42CrMo4/Timer/requirementsSW.rtf

Startup:
- wake from deep sleep on any key stroke with interrupt (Flag int)

Going to sleep:
- Always if idl (no timer, stopwatch running) go to sleep after „idl_timeout“ in sec after the last input
- The „idl_timeout“ should be configurable at the beginning of the sketch

Timer funktion:
- input time in format hh:mm:ss but start with the right most digit (s) and shift then to the left.
- example: input 13min and 25sec
- 00:00:00 (start frame)
- 00:00:01 (enter 1)
- 00:00:13 (enter 3)
- 00:01:32 (enter 2)
- 00:13:25 (enter 5)
- start timer with press on Start Key (Flag ButtonStart)
- OLED should show the time remaining
- (optional) OLED should show a hourglass symbol before time
- If running Pause Timer with press on Start Key (Flag ButtonStart)
- (optional) OLED should not show a hourglass symbol before time
- Reset Timer by pressing Reset Key (Flag ButtonReset)
- if running or in paused mode rest to the last input time (example from bevor 13:25)
- if reseted again then go to 00:00:00
- in input mode reset to 00:00:00
- If Time reaches 00:00:00
- the buzzer (Flag Buzzer) should sound.
- The frequency should be configurable at the beginning of the sketch
- The duration should be configurable at the beginning of the sketch
- (optional) the display should invert the colors 5 times (to have a blinking effect)
- the time should go on and count up (so that you know the elapsed time since the end of the timer
- (optional) The hourglass should be changed to a big „E“

Stopwatch funktion:
- start stopwatch with press on Start Key (Flag ButtonStart)
- OLED should show the time elapsed
- (optional) OLED should show a stopwatch symbol before time
- If running Pause stopwatch with press on Start Key (Flag ButtonStart)
- Reset stopwatch if running or in paused mode by pressing Reset Key (Flag ButtonReset)

Generell Concept:
- Arduino IDE
- Microcontroller Attiny1616
- use megaTinyCore (https://github.com/SpenceKonde/megaTinyCore)
- No floating pins in sleep mode (https://github.com/SpenceKonde/megaTinyCore/blob/master/megaavr/extras/PowerSave.md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)
- only open source Libraries
- if possible good maintained Libraries
- functions without delay
- icons used or inspired from the material design collection (https://materialdesignicons.com/)
