42CrMo4/Timer/Timer.kicad_pcb

## KiCad design Timer.kicad_pcb (2021-09-29)

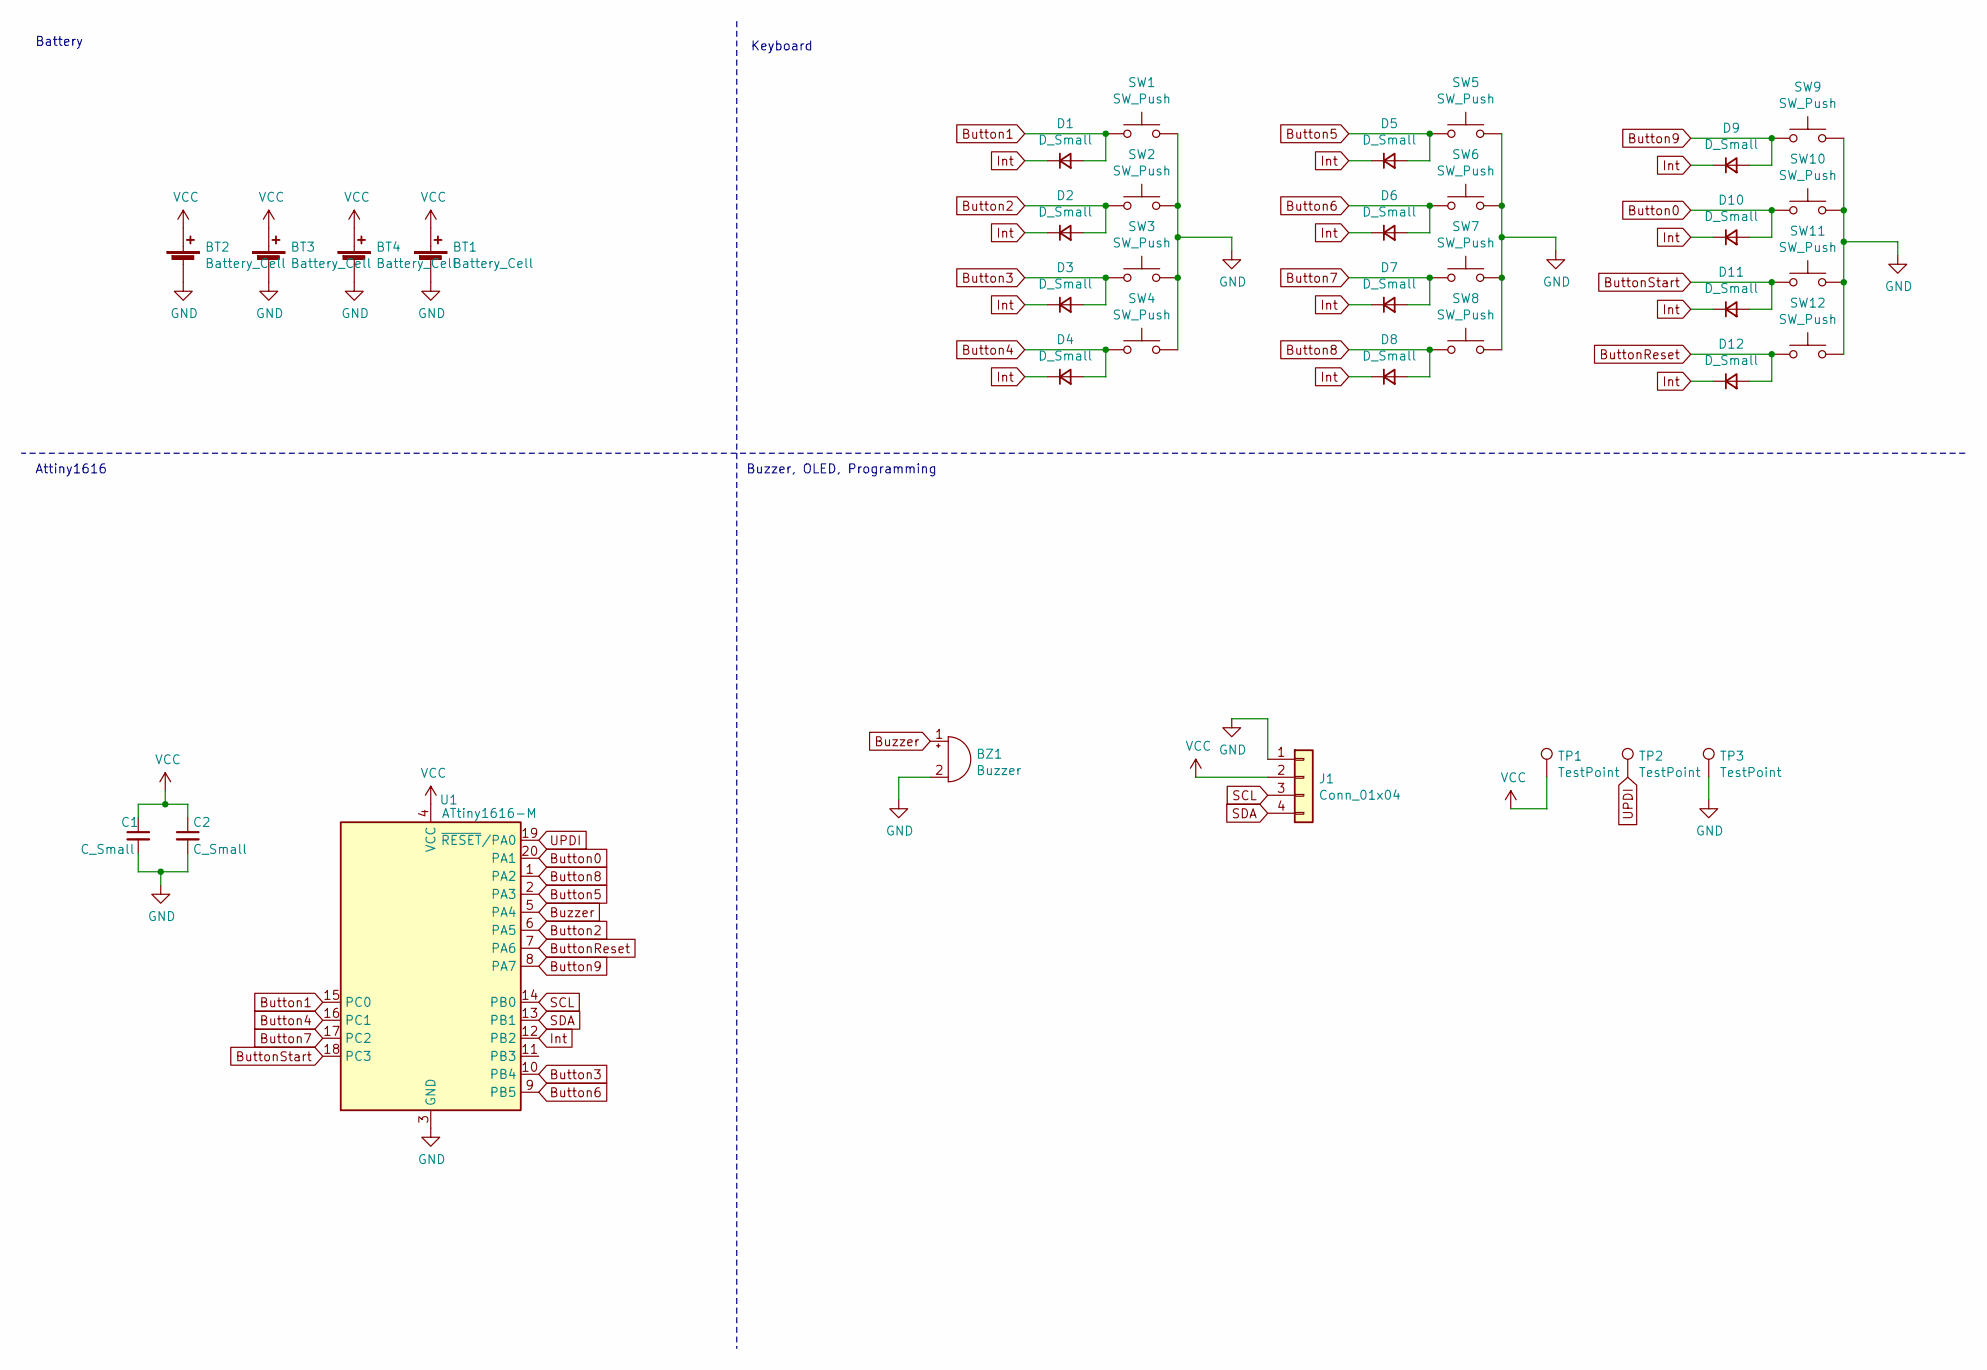
[picture p1: schematic Timer.sch]

Parts:
BT1, BT2, BT3, BT4: Battery_Cell; BatteryHolder_3DPrint_1xAAA
BZ1: Buzzer; Buzzer_12x9.5RM7.6
C1, C2: C_Small; C_0805_2012Metric
D1, D2, D3, D4, D5, D6, D7, D8, D9, D10, D11, D12: D_Small; D_0805_2012Metric
J1: Conn_01x04; PinHeader_1x04_P2.54mm_Vertical
SW1, SW2, SW3, SW4, SW5, SW6, SW7, SW8, SW9, SW10, SW11, SW12: SW_Push; SW_Cherry_MX_1.00u_PCB
TP1, TP2, TP3: TestPoint; TestPoint_Pad_D1.5mm
U1: ATtiny1616-M; VQFN-20-1EP_3x3mm_P0.4mm_EP1.7x1.7mm

Connections:
Button0: D10.2 (A), SW10.1, U1.20 (PA1)
Button1: D1.2 (A), SW1.1, U1.15 (PC0)
Button2: D2.2 (A), SW2.1, U1.6 (PA5)
Button3: D3.2 (A), SW3.1, U1.10 (PB4)
Button4: D4.2 (A), SW4.1, U1.16 (PC1)
Button5: D5.2 (A), SW5.1, U1.2 (PA3)
Button6: D6.2 (A), SW6.1, U1.9 (PB5)
Button7: D7.2 (A), SW7.1, U1.17 (PC2)
Button8: D8.2 (A), SW8.1, U1.1 (PA2)
Button9: D9.2 (A), SW9.1, U1.8 (PA7)
ButtonReset: D12.2 (A), SW12.1, U1.7 (PA6)
ButtonStart: D11.2 (A), SW11.1, U1.18 (PC3)
Buzzer: BZ1.1 (-), U1.5 (PA4)
GND: BT1.2 (-), BT2.2 (-), BT3.2 (-), BT4.2 (-), BZ1.2 (+), C1.2, C2.2, J1.1, SW1.2, SW2.2, SW3.2, SW4.2, SW5.2, SW6.2, SW7.2, SW8.2, SW9.2, SW10.2, SW11.2, SW12.2, TP3.1, U1.3 (GND), U1.21 (GND)
Int: D1.1 (K), D2.1 (K), D3.1 (K), D4.1 (K), D5.1 (K), D6.1 (K), D7.1 (K), D8.1 (K), D9.1 (K), D10.1 (K), D11.1 (K), D12.1 (K), U1.12 (PB2)
SCL: J1.3, U1.14 (PB0)
SDA: J1.4, U1.13 (PB1)
UPDI: TP2.1, U1.19 (~RESET~/PA0)
VCC: BT1.1 (+), BT2.1 (+), BT3.1 (+), BT4.1 (+), C1.1, C2.1, J1.2, TP1.1, U1.4 (VCC)

Notes on the sheet:
Battery
Keyboard
Attiny1616
Buzzer, OLED, Programming

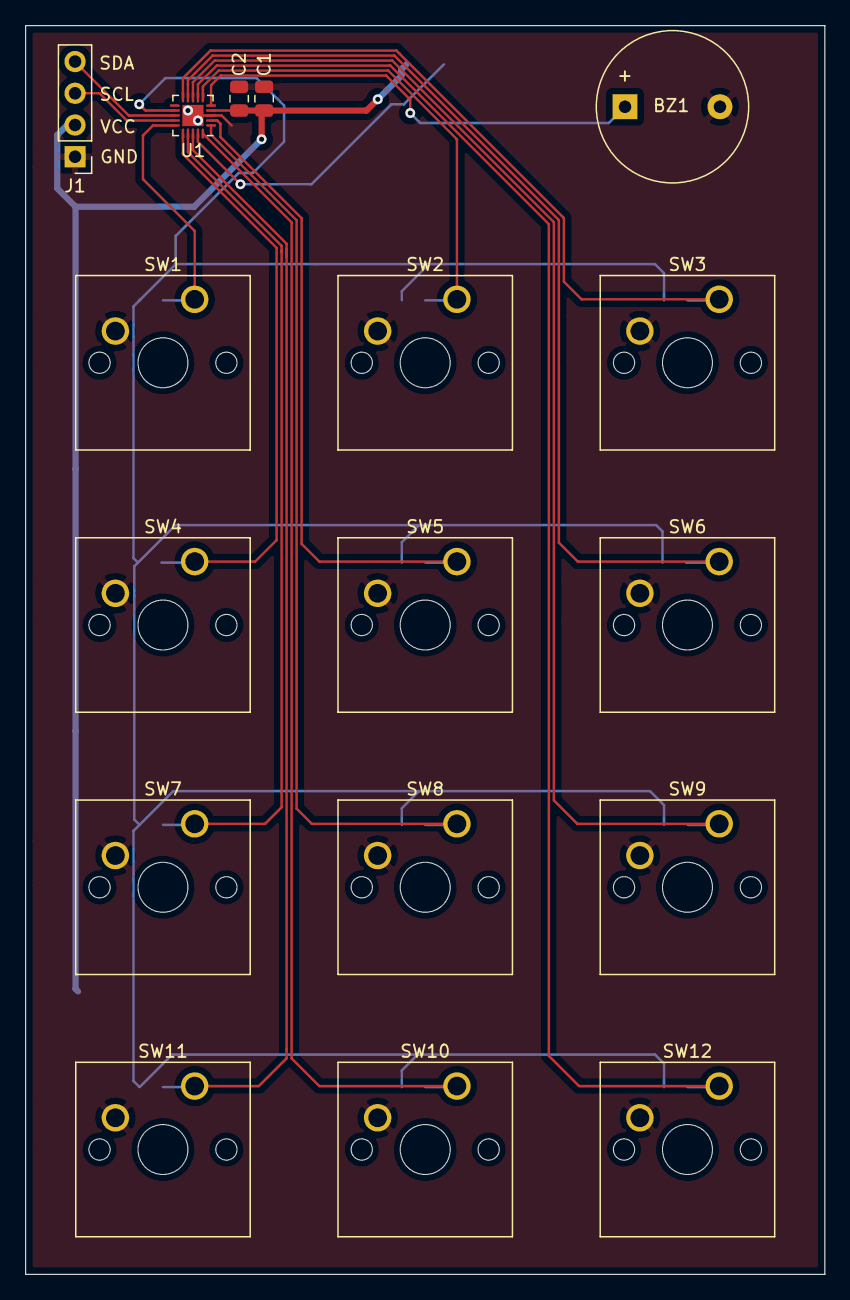
[picture p2: board Timer.kicad_pcb from above]

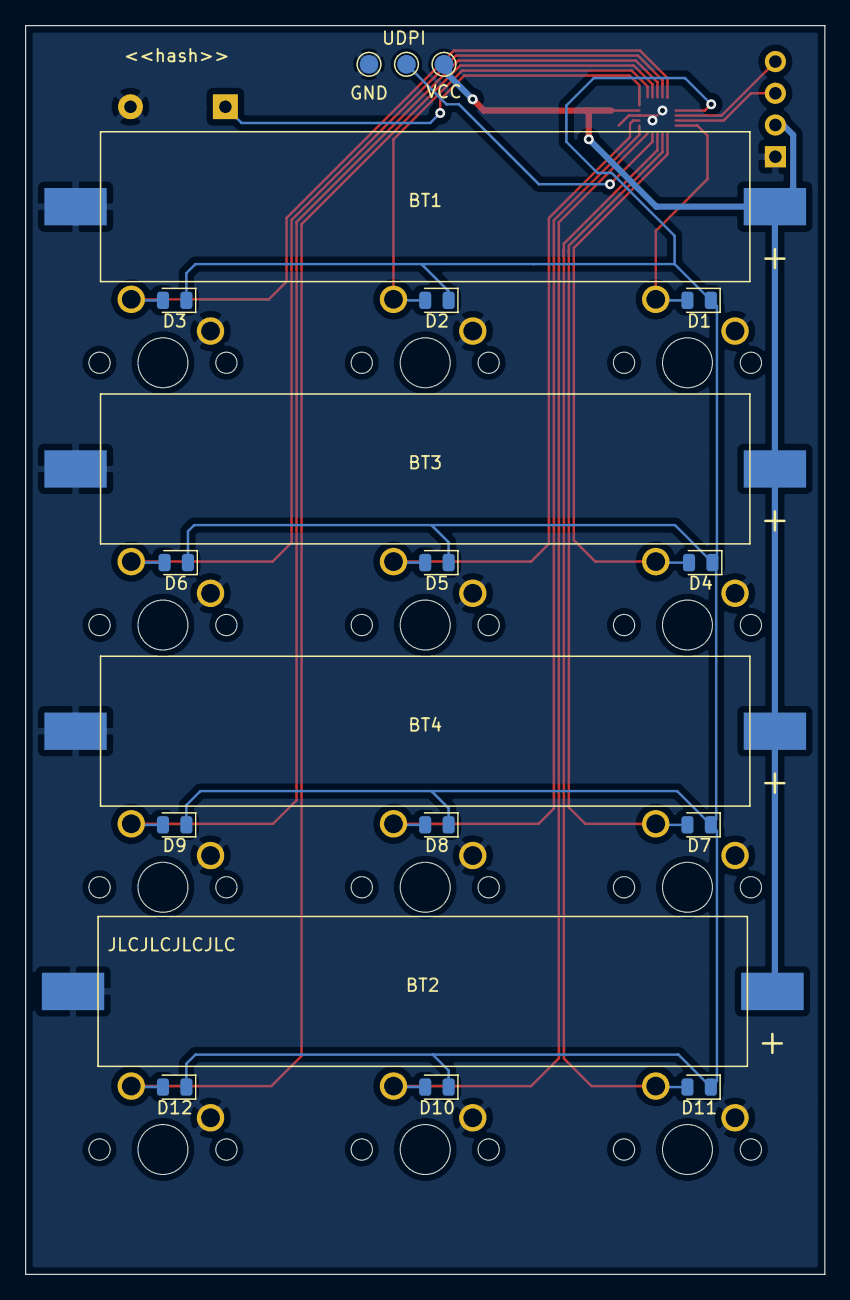
[picture p3: board Timer.kicad_pcb from below]

Board: 2 copper layers, 64.0 x 100.0 mm, 36 parts (19 on the bottom side), 19 nets.
