42CrMo4/Timer/(commit log)

2021-09-25 add SCH/PCB/Req
    [Timer.kicad_pcb, Timer.sch]
2021-09-27 add pcbdraw to WF
2021-09-29 add Silkscreen move Testpoints
    [Timer.kicad_pcb]
2021-09-29 update gnd fill
    [Timer.kicad_pcb]
2021-10-13 add timer Sketch
2021-11-01 add battery status
2021-11-01 add all buttons
